CECS447-115902/CECS490A-Team1/hardware/pcb/README.md

# pcb/

KiCad project for the custom bracelet PCB.

- `bandlink_rev_a/`: first spin (flat test board)
- Pin assignment comes from `firmware/bandlink/bsp/bandlink_rev_a/cubemx/*.ioc`. Update both together.
- Export BOM CSVs to `hardware/bom/` and schematic PDFs to `hardware/schematic/` at each review.
