CECS447-115902/CECS490A-Team1/firmware/tools/README.md

# tools/

Scripts that help develop and test the firmware, for example:
- flashing helpers (STM32CubeProgrammer CLI)
- UART log capture from the pogo dock
- a LoRa packet decoder for sniffed captures (verifies R-06)
- PPK2 power-log analysis against the power budget
