CECS447-115902/CECS490A-Team1/reference/osptek-amoled-1.73-co5300/versions/AM173Q466466FLS/README.md

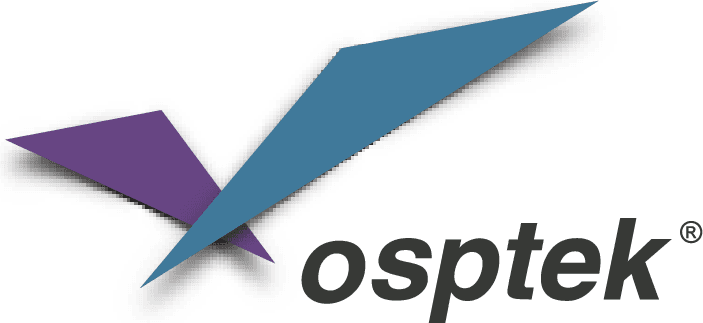
[picture p1: reference/osptek-amoled-1.73-co5300/versions/AM173Q466466FLS/images/logo.png]
OSPTEK


<h1 align="center">OSPTEK 1.73″ AMOLED 466×466（CO5300 · QSPI）</h1>

<p align="center"><b>圆形 AMOLED 模组 · QSPI · CO5300 · 电容触摸</b></p>

<p align="center"><a href="./README_EN.md">English</a> | 简体中文 · <a href="../../README.md">规格族索引</a></p>

<p align="center">
  
  
  
  
</p>

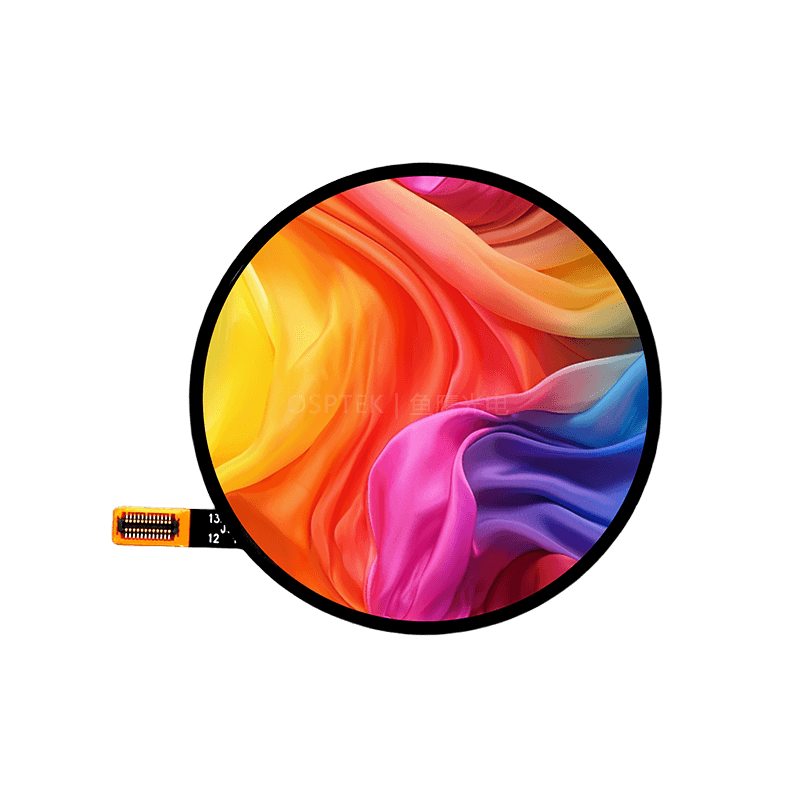
[picture p2: reference/osptek-amoled-1.73-co5300/versions/AM173Q466466FLS/images/product.png]
OSPTEK 1.73 寸 466×466 AMOLED QSPI 模组（CO5300）宣传图


## 目录

- [产品简介](#产品简介)
- [规格参数](#规格参数)
- [预编译固件](#预编译固件)
- [示例工程](#示例工程)
- [仓库结构](#仓库结构)
- [相关资料](#相关资料)
- [购买链接](#购买链接)
- [技术支持](#技术支持)

---

## 产品简介

OSPTEK **1.73 寸 466×466 AMOLED** 是一款 **QSPI** 接口圆形彩色显示模组，显示驱动为 **CO5300**，触摸驱动为 **CST820**。适合穿戴表盘、圆形仪表与小型圆形 HMI 等场景。

规格标识（仓库名）：`amoled-1.73-466x466-qspi-co5300`

当前模组版本：**AM173Q466466FLS**。电气与外形细节以 [`docs/AM_173_Q466466_FLS_c3c39f821c.pdf`](./docs/AM_173_Q466466_FLS_c3c39f821c.pdf) 为准。

## 规格参数

| 项目 | 规格 |
| ---- | ---- |
| 尺寸 | 1.73 英寸 |
| 类型 | AMOLED（彩色，圆形） |
| 分辨率 | 466×466 |
| 接口 | QSPI |
| 驱动 IC | CO5300 |
| 触摸驱动 | CST820 |

> 完整外形尺寸、FPC 定义、供电与时序以产品规格书 / 驱动手册为准。

## 预编译固件

不装 ESP-IDF 时可先烧录下面合并包，验证显示与触摸。

**建议适配组合：** 本模组（AM173Q466466FLS）+ **ESP32-S3 Demo 板**。其它主控 / 接线需自行改固件或源码。

| 底板（ESP32-S3 Demo） | 转接板 / 模组（AM173Q466466FLS） | 插接示意 |
| --- | --- | --- |
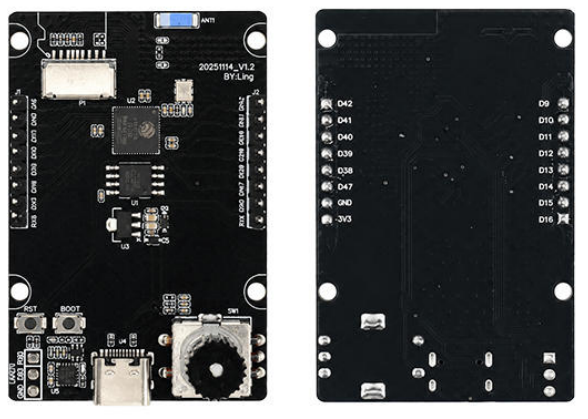
[picture p3: reference/osptek-amoled-1.73-co5300/versions/AM173Q466466FLS/images/esp32-s3-demo-board.png]
ESP32-S3 Demo 板
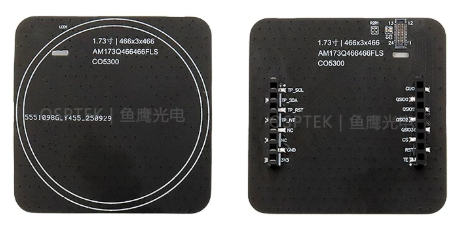
[picture p4: reference/osptek-amoled-1.73-co5300/versions/AM173Q466466FLS/images/module-front-back.png]
AM173Q466466FLS 模组
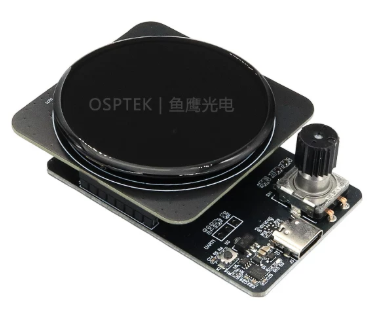
[picture p5: reference/osptek-amoled-1.73-co5300/versions/AM173Q466466FLS/images/assembled.png]
模组插接在 S3 Demo 板上
|  |  |  |

**引脚定义**

| 功能 | GPIO |
| ---- | ---- |
| LCD CS | 14 |
| LCD PCLK (CLK) | 9 |
| LCD DATA0 | 10 |
| LCD DATA1 | 11 |
| LCD DATA2 | 12 |
| LCD DATA3 | 13 |
| LCD RST | 15 |
| TOUCH SCL | 42 |
| TOUCH SDA | 41 |
| TOUCH RST | 40 |
| TOUCH INT | 39 |

| 文件 | 烧录地址 | 说明 |
| ---- | --- | ---- |
| [`firmware/esp32s3-amoled-1.73-466x466-qspi-co5300-bringup.bin`](./firmware/esp32s3-amoled-1.73-466x466-qspi-co5300-bringup.bin) | `0x0`（合并包） | 适配上方 S3 Demo 板 + 本模组的 bringup |

> 合并包请烧到 **`0x0`**，不要当成应用分区去烧 `0x10000`。

## 示例工程

| 说明 | 路径 |
| ---- | ---- |
| ESP32-S3 · CO5300 QSPI + esp-lvgl-adapter / LVGL8 | [`examples/esp32s3-idf5_co5300-qspi_esp-lvgl-adapter_lvgl8/`](./examples/esp32s3-idf5_co5300-qspi_esp-lvgl-adapter_lvgl8/) |
| ESP32-S3 · CO5300 QSPI + esp-lvgl-adapter / LVGL9 | [`examples/esp32s3-idf5_co5300-qspi_esp-lvgl-adapter_lvgl9/`](./examples/esp32s3-idf5_co5300-qspi_esp-lvgl-adapter_lvgl9/) |
| ESP32-S3 · LVGL8 + TE 防撕裂 | [`examples/with-te/esp32s3-idf5_co5300-qspi_esp-lvgl-adapter_lvgl8_amoled-with-te/`](./examples/with-te/esp32s3-idf5_co5300-qspi_esp-lvgl-adapter_lvgl8_amoled-with-te/) |
| ESP32-S3 · LVGL9 + TE 防撕裂 | [`examples/with-te/esp32s3-idf5_co5300-qspi_esp-lvgl-adapter_lvgl9_amoled-with-te/`](./examples/with-te/esp32s3-idf5_co5300-qspi_esp-lvgl-adapter_lvgl9_amoled-with-te/) |

## 仓库结构

```text
amoled-1.73-466x466-qspi-co5300/                                # 仓库根（导航见 ../../README.md）
└── versions/
    └── AM173Q466466FLS/                                # 本料号完整资料
        ├── README.md
        ├── README_EN.md
        ├── images/
        ├── docs/
        ├── firmware/
        └── examples/
```

## 相关资料

### 本产品资料

| 资料 | 链接 |
| ---- | ---- |
| 产品规格书（AM173Q466466FLS） | [`docs/AM_173_Q466466_FLS_c3c39f821c.pdf`](./docs/AM_173_Q466466_FLS_c3c39f821c.pdf) |
| 驱动 IC 数据手册（CO5300） | [`docs/CO_5300_Datasheet_V0_00_20230328_07edb82936.pdf`](./docs/CO_5300_Datasheet_V0_00_20230328_07edb82936.pdf) |
| 触摸 IC 数据手册（CST820） | [`docs/DS_CST_820_V1_2_e0543732ca.pdf`](./docs/DS_CST_820_V1_2_e0543732ca.pdf) |
| 初始化序列（文本） | [`docs/1.73_QSPI.txt`](./docs/1.73_QSPI.txt) |
| 1.73 寸 AMOLED 转接板原理图 | [`docs/1.73寸AMOLED转接板原理图.png`](./docs/1.73%E5%AF%B8AMOLED%E8%BD%AC%E6%8E%A5%E6%9D%BF%E5%8E%9F%E7%90%86%E5%9B%BE.png) |
| 1.73 寸 AMOLED QSPI 转接板 | [`docs/PCB-1.73寸AMOLED屏QSPI转接板.pdf`](./docs/PCB-1.73%E5%AF%B8AMOLED%E5%B1%8FQSPI%E8%BD%AC%E6%8E%A5%E6%9D%BF.pdf) |
| 连接器规格书（OK-23GF024-04） | [`docs/OK-23GF024-04.pdf`](./docs/OK-23GF024-04.pdf) |
| 预编译固件（ESP32-S3 合并包） | [`firmware/esp32s3-amoled-1.73-466x466-qspi-co5300-bringup.bin`](./firmware/esp32s3-amoled-1.73-466x466-qspi-co5300-bringup.bin) |

### 示例工程

- [ESP32-S3 CO5300 QSPI + LVGL8](./examples/esp32s3-idf5_co5300-qspi_esp-lvgl-adapter_lvgl8/)
- [ESP32-S3 CO5300 QSPI + LVGL9](./examples/esp32s3-idf5_co5300-qspi_esp-lvgl-adapter_lvgl9/)
- [ESP32-S3 LVGL8 + TE](./examples/with-te/esp32s3-idf5_co5300-qspi_esp-lvgl-adapter_lvgl8_amoled-with-te/)
- [ESP32-S3 LVGL9 + TE](./examples/with-te/esp32s3-idf5_co5300-qspi_esp-lvgl-adapter_lvgl9_amoled-with-te/)

## 购买链接

<p align="center">
  
  &nbsp;&nbsp;
  
</p>

**国内（淘宝）**

- 店铺：[鱼鹰光电工厂店](https://shop110742373.taobao.com/)

**海外（AliExpress）**

- 店铺：[OSPTEK Official Store](https://www.aliexpress.com/store/1105701619)

## 技术支持

- 技术支持 / 产品咨询：<luyu@osptek.com>
- QQ 技术交流群：**985881096**
- 公司官网：<https://osptek.com/>
- 有任何问题，都可以在本仓库 Issues 中提问

---

<p align="center"><sub>© 2026 OSPTEK 鱼鹰光电 · 本仓库资料采用 CC BY 4.0 许可</sub></p>
