CECS447-115902/CECS490A-Team1/reference/osptek-amoled-1.73-co5300/versions/AM173Q466466FLS/README_EN.md

<p align="left">OSPTEK</p>

<h1 align="center">OSPTEK 1.73″ AMOLED 466×466 (CO5300 · QSPI)</h1>

<p align="center"><b>Round AMOLED module · QSPI · CO5300 · capacitive touch</b></p>

<p align="center"><a href="./README.md">简体中文</a> | English · <a href="../../README_EN.md">Family index</a></p>

<p align="center">
  
  
  
  
</p>

<p align="center">OSPTEK 1.73 inch 466×466 AMOLED QSPI module (CO5300) product image</p>

## Contents

- [Overview](#overview)
- [Specifications](#specifications)
- [Prebuilt firmware](#prebuilt-firmware)
- [Sample projects](#sample-projects)
- [Repository layout](#repository-layout)
- [Resources](#resources)
- [Buy](#buy)
- [Support](#support)

---

## Overview

OSPTEK **1.73″ 466×466 AMOLED** is a round **QSPI** color display module driven by **CO5300**, with capacitive touch (**CST820**). Suited to wearables, round gauges, and compact circular HMI.

Spec ID (repository name): `amoled-1.73-466x466-qspi-co5300`

Current module version: **AM173Q466466FLS**. Electrical and mechanical details follow [`docs/AM_173_Q466466_FLS_c3c39f821c.pdf`](./docs/AM_173_Q466466_FLS_c3c39f821c.pdf).

## Specifications

| Item | Spec |
| ---- | ---- |
| Size | 1.73 inch |
| Type | AMOLED (color, round) |
| Resolution | 466×466 |
| Interface | QSPI |
| Driver IC | CO5300 |
| Touch driver | CST820 |

> Full outline, FPC definition, power, and timing follow the product datasheet / driver IC datasheet.

## Prebuilt firmware

Flash the merged image below to verify display and touch without building ESP-IDF.

**Intended hardware:** this module (AM173Q466466FLS) + the **ESP32-S3 Demo board**. Other MCUs / wiring need a different firmware or your own port.

| Base board (ESP32-S3 Demo) | Adapter / module (AM173Q466466FLS) | Assembled |
| --- | --- | --- |
| ESP32-S3 Demo board | AM173Q466466FLS module | Module plugged into S3 Demo board |

**Pin map**

| Function | GPIO |
| --- | ---- |
| LCD CS | 14 |
| LCD PCLK (CLK) | 9 |
| LCD DATA0 | 10 |
| LCD DATA1 | 11 |
| LCD DATA2 | 12 |
| LCD DATA3 | 13 |
| LCD RST | 15 |
| TOUCH SCL | 42 |
| TOUCH SDA | 41 |
| TOUCH RST | 40 |
| TOUCH INT | 39 |

| File | Address | Notes |
| ---- | --- | ----- |
| [`firmware/esp32s3-amoled-1.73-466x466-qspi-co5300-bringup.bin`](./firmware/esp32s3-amoled-1.73-466x466-qspi-co5300-bringup.bin) | `0x0` (merged) | Bringup for the S3 Demo board + this module |

> Flash the merged image at **`0x0`**, not `0x10000`.

## Sample projects

| Description | Path |
| ---- | ---- |
| ESP32-S3 · CO5300 QSPI + esp-lvgl-adapter / LVGL8 | [`examples/esp32s3-idf5_co5300-qspi_esp-lvgl-adapter_lvgl8/`](./examples/esp32s3-idf5_co5300-qspi_esp-lvgl-adapter_lvgl8/) |
| ESP32-S3 · CO5300 QSPI + esp-lvgl-adapter / LVGL9 | [`examples/esp32s3-idf5_co5300-qspi_esp-lvgl-adapter_lvgl9/`](./examples/esp32s3-idf5_co5300-qspi_esp-lvgl-adapter_lvgl9/) |
| ESP32-S3 · LVGL8 + TE | [`examples/with-te/esp32s3-idf5_co5300-qspi_esp-lvgl-adapter_lvgl8_amoled-with-te/`](./examples/with-te/esp32s3-idf5_co5300-qspi_esp-lvgl-adapter_lvgl8_amoled-with-te/) |
| ESP32-S3 · LVGL9 + TE | [`examples/with-te/esp32s3-idf5_co5300-qspi_esp-lvgl-adapter_lvgl9_amoled-with-te/`](./examples/with-te/esp32s3-idf5_co5300-qspi_esp-lvgl-adapter_lvgl9_amoled-with-te/) |

## Repository layout

```text
amoled-1.73-466x466-qspi-co5300/                                # repo root (nav: ../../README_EN.md)
└── versions/
    └── AM173Q466466FLS/                                # full materials for this part number
        ├── README.md
        ├── README_EN.md
        ├── images/
        ├── docs/
        ├── firmware/
        └── examples/
```

## Resources

### Product files

| Resource | Link |
| ---- | ---- |
| Product datasheet (AM173Q466466FLS) | [`docs/AM_173_Q466466_FLS_c3c39f821c.pdf`](./docs/AM_173_Q466466_FLS_c3c39f821c.pdf) |
| Driver IC datasheet (CO5300) | [`docs/CO_5300_Datasheet_V0_00_20230328_07edb82936.pdf`](./docs/CO_5300_Datasheet_V0_00_20230328_07edb82936.pdf) |
| Touch IC datasheet (CST820) | [`docs/DS_CST_820_V1_2_e0543732ca.pdf`](./docs/DS_CST_820_V1_2_e0543732ca.pdf) |
| Init sequence (text) | [`docs/1.73_QSPI.txt`](./docs/1.73_QSPI.txt) |
| 1.73″ AMOLED adapter schematic | [`docs/1.73寸AMOLED转接板原理图.png`](./docs/1.73%E5%AF%B8AMOLED%E8%BD%AC%E6%8E%A5%E6%9D%BF%E5%8E%9F%E7%90%86%E5%9B%BE.png) |
| 1.73″ AMOLED QSPI adapter board | [`docs/PCB-1.73寸AMOLED屏QSPI转接板.pdf`](./docs/PCB-1.73%E5%AF%B8AMOLED%E5%B1%8FQSPI%E8%BD%AC%E6%8E%A5%E6%9D%BF.pdf) |
| Connector datasheet (OK-23GF024-04) | [`docs/OK-23GF024-04.pdf`](./docs/OK-23GF024-04.pdf) |
| Prebuilt firmware (ESP32-S3 merged) | [`firmware/esp32s3-amoled-1.73-466x466-qspi-co5300-bringup.bin`](./firmware/esp32s3-amoled-1.73-466x466-qspi-co5300-bringup.bin) |

### Samples

- [ESP32-S3 CO5300 QSPI + LVGL8](./examples/esp32s3-idf5_co5300-qspi_esp-lvgl-adapter_lvgl8/)
- [ESP32-S3 CO5300 QSPI + LVGL9](./examples/esp32s3-idf5_co5300-qspi_esp-lvgl-adapter_lvgl9/)
- [ESP32-S3 LVGL8 + TE](./examples/with-te/esp32s3-idf5_co5300-qspi_esp-lvgl-adapter_lvgl8_amoled-with-te/)
- [ESP32-S3 LVGL9 + TE](./examples/with-te/esp32s3-idf5_co5300-qspi_esp-lvgl-adapter_lvgl9_amoled-with-te/)

## Buy

<p align="center">
  
  &nbsp;&nbsp;
  
</p>

**Overseas (AliExpress)**

- Store: [OSPTEK Official Store](https://www.aliexpress.com/store/1105701619)

**China (Taobao)**

- Store: [鱼鹰光电工厂店](https://shop110742373.taobao.com/)

## Support

- Technical support / product inquiry: <luyu@osptek.com>
- QQ group (China): **985881096**
- Website: <https://osptek.com/>
- Feel free to open an Issue in this repository if you have any questions

---

<p align="center"><sub>© 2026 OSPTEK · Materials in this repository are licensed under CC BY 4.0</sub></p>
