CECS447-115902/CECS490A-Team1/reference/osptek-amoled-1.73-co5300/versions/AM173Q466466FLS32/README_EN.md

<p align="left">OSPTEK</p>

<h1 align="center">OSPTEK 1.73″ AMOLED 466×466 (CO5300 · QSPI)</h1>

<p align="center"><b>Round AMOLED module · QSPI · CO5300 · capacitive touch</b></p>

<p align="center"><a href="./README.md">简体中文</a> | English · <a href="../../README_EN.md">Family index</a></p>

<p align="center">
  
  
  
  
</p>

## Contents

- [Overview](#overview)
- [Specifications](#specifications)
- [Repository layout](#repository-layout)
- [Resources](#resources)
- [Buy](#buy)
- [Support](#support)

---

## Overview

OSPTEK **1.73″ 466×466 AMOLED** is a round **QSPI** color display module driven by **CO5300**, with capacitive touch (**CST820**). Suited to wearables, round gauges, and compact circular HMI.

Spec ID (repository name): `amoled-1.73-466x466-qspi-co5300`

Current module version: **AM173Q466466FLS32**. Electrical and mechanical details follow [`docs/AM173Q466466FLS32.pdf`](./docs/AM173Q466466FLS32.pdf).

## Specifications

| Item | Spec |
| ---- | ---- |
| Size | 1.73 inch |
| Type | AMOLED (color, round) |
| Resolution | 466×466 |
| Interface | QSPI |
| Driver IC | CO5300 |
| Touch driver | CST820 |

> Full outline, FPC definition, power, and timing follow the product datasheet / driver IC datasheet.

## Repository layout

```text
amoled-1.73-466x466-qspi-co5300/                                # repo root (nav: ../../README_EN.md)
└── versions/
    └── AM173Q466466FLS32/                                      # full materials for this part number
        ├── README.md
        ├── README_EN.md
        ├── images/
        └── docs/
```

## Resources

### Product files

| Resource | Link |
| ---- | ---- |
| Product datasheet (AM173Q466466FLS32) | [`docs/AM173Q466466FLS32.pdf`](./docs/AM173Q466466FLS32.pdf) |
| Outline CAD (AM173Q466466FLS32) | [`docs/AM173Q466466FLS32.dwg`](./docs/AM173Q466466FLS32.dwg) |
| Driver IC datasheet (CO5300) | [`docs/CO_5300_Datasheet_V0_00_20230328_07edb82936.pdf`](./docs/CO_5300_Datasheet_V0_00_20230328_07edb82936.pdf) |
| Touch IC datasheet (CST820) | [`docs/DS_CST_820_V1_2_e0543732ca.pdf`](./docs/DS_CST_820_V1_2_e0543732ca.pdf) |

## Buy

<p align="center">
  
  &nbsp;&nbsp;
  
</p>

**International (AliExpress)**

- Store: [OSPTEK Official Store](https://www.aliexpress.com/store/1105701619)

**China (Taobao)**

- Store: [鱼鹰光电工厂店](https://shop110742373.taobao.com/)

## Support

- Technical Support / Sales: <luyu@osptek.com>
- QQ Technical Group: **985881096**
- Website: <https://osptek.com/>
- Feel free to open an Issue in this repository if you have any questions

---

<p align="center"><sub>© 2026 OSPTEK · Licensed under CC BY 4.0</sub></p>
