CECS447-115902/CECS490A-Team1/reference/osptek-amoled-1.73-co5300/README.md

<p align="left">OSPTEK</p>

<h1 align="center">OSPTEK 1.73″ AMOLED 466×466（CO5300 · QSPI）</h1>

<p align="center"><b>AMOLED 模组 · QSPI · CO5300 · 多版本索引</b></p>

<p align="center"><a href="./README_EN.md">English</a> | 简体中文</p>

<p align="center">
  
  
  
  
</p>

## 目录

- [说明](#说明)
- [版本一览](#版本一览)
- [AM173Q466466FLS32](#am173q466466fls32)
- [AM173Q466466FLS](#am173q466466fls)
- [购买链接](#购买链接)
- [技术支持](#技术支持)

---

## 说明

本仓库收录 **1.73 寸 466×466 AMOLED（QSPI · CO5300）** 显示模组资料。

**根目录 README 为导航页**。下表可快速浏览各版本；点击「完整资料」进入 `versions/` 下对应**料号文件夹**（产品页、规格书、示例均在该目录内）。

规格标识（仓库名）：`amoled-1.73-466x466-qspi-co5300`

---

## 版本一览

| 版本 | 宣传图 | 简介 | 完整资料 |
| ---- | --- | ---- | --- |
| AM173Q466466FLS32 |  | [简介](#am173q466466fls32) | [完整资料](./versions/AM173Q466466FLS32/) |
| AM173Q466466FLS | AM173Q466466FLS | [简介](#am173q466466fls) | [完整资料](./versions/AM173Q466466FLS/) |

---

## AM173Q466466FLS32

**说明：** 带触摸（CST820），FPC 24 Pin。

完整产品页、规格书与示例：[versions/AM173Q466466FLS32/](./versions/AM173Q466466FLS32/)

---

## AM173Q466466FLS

<p align="center">AM173Q466466FLS</p>

**说明：** 带触摸（CST820）。

完整产品页、规格书与示例：[versions/AM173Q466466FLS/](./versions/AM173Q466466FLS/)

---

## 购买链接

<p align="center">
  
  &nbsp;&nbsp;
  
</p>

**国内（淘宝）**

- 店铺：[鱼鹰光电工厂店](https://shop110742373.taobao.com/)

**海外（AliExpress）**

- 店铺：[OSPTEK Official Store](https://www.aliexpress.com/store/1105701619)

---

## 技术支持

- 技术支持 / 产品咨询：<luyu@osptek.com>
- QQ 技术交流群：**985881096**
- 公司官网：<https://osptek.com/>
- 有任何问题，都可以在本仓库 Issues 中提问

---

<p align="center"><sub>© 2026 OSPTEK 鱼鹰光电 · 本仓库资料采用 CC BY 4.0 许可</sub></p>
