CECS447-115902/CECS490A-Team1/reference/osptek-amoled-1.73-co5300/README_EN.md

<p align="left">OSPTEK</p>

<h1 align="center">OSPTEK 1.73″ AMOLED 466×466 (CO5300 · QSPI)</h1>

<p align="center"><b>AMOLED module · QSPI · CO5300 · Multi-Version Index</b></p>

<p align="center">English | <a href="./README.md">简体中文</a></p>

<p align="center">
  
  
  
  
</p>

## Contents

- [About](#about)
- [Versions](#versions)
- [AM173Q466466FLS32](#am173q466466fls32)
- [AM173Q466466FLS](#am173q466466fls)
- [Where to Buy](#where-to-buy)
- [Support](#support)

---

## About

This repository holds materials for the **1.73″ 466×466 AMOLED (QSPI · CO5300)** module family.

The **root README is the navigation page**. Use the table below for a quick scan; open **Full docs** to enter that **part-number folder** under `versions/` (product page, datasheets, and examples live there).

Repo id: `amoled-1.73-466x466-qspi-co5300`

---

## Versions

| Version | Image | Summary | Full docs |
| --- | ----- | --- | --- |
| AM173Q466466FLS32 |  | [Summary](#am173q466466fls32) | [Full docs](./versions/AM173Q466466FLS32/) |
| AM173Q466466FLS | AM173Q466466FLS | [Summary](#am173q466466fls) | [Full docs](./versions/AM173Q466466FLS/) |

---

## AM173Q466466FLS32

**Notes:** With touch (CST820), 24-pin FPC.

Full product page, datasheets, and examples: [versions/AM173Q466466FLS32/](./versions/AM173Q466466FLS32/)

---

## AM173Q466466FLS

<p align="center">AM173Q466466FLS</p>

**Notes:** With touch (CST820).

Full product page, datasheets, and examples: [versions/AM173Q466466FLS/](./versions/AM173Q466466FLS/)

---

## Where to Buy

<p align="center">
  
  &nbsp;&nbsp;
  
</p>

**International (AliExpress)**

- Store: [OSPTEK Official Store](https://www.aliexpress.com/store/1105701619)

**China (Taobao)**

- Store: [鱼鹰光电工厂店](https://shop110742373.taobao.com/)

---

## Support

- Technical Support / Sales: <luyu@osptek.com>
- QQ Technical Group: **985881096**
- Website: <https://osptek.com/>
- Feel free to open an Issue in this repository if you have any questions

---

<p align="center"><sub>© 2026 OSPTEK · Licensed under CC BY 4.0</sub></p>
