CECS447-115902/CECS490A-Team1/reference/osptek-amoled-1.73-co5300/versions/AM173Q466466FLS32/README.md

<p align="left">OSPTEK</p>

<h1 align="center">OSPTEK 1.73″ AMOLED 466×466（CO5300 · QSPI）</h1>

<p align="center"><b>圆形 AMOLED 模组 · QSPI · CO5300 · 电容触摸</b></p>

<p align="center"><a href="./README_EN.md">English</a> | 简体中文 · <a href="../../README.md">规格族索引</a></p>

<p align="center">
  
  
  
  
</p>

## 目录

- [产品简介](#产品简介)
- [规格参数](#规格参数)
- [仓库结构](#仓库结构)
- [相关资料](#相关资料)
- [购买链接](#购买链接)
- [技术支持](#技术支持)

---

## 产品简介

OSPTEK **1.73 寸 466×466 AMOLED** 是一款 **QSPI** 接口圆形彩色显示模组，显示驱动为 **CO5300**，触摸驱动为 **CST820**。适合穿戴表盘、圆形仪表与小型圆形 HMI 等场景。

规格标识（仓库名）：`amoled-1.73-466x466-qspi-co5300`

当前模组版本：**AM173Q466466FLS32**。电气与外形细节以 [`docs/AM173Q466466FLS32.pdf`](./docs/AM173Q466466FLS32.pdf) 为准。

## 规格参数

| 项目 | 规格 |
| ---- | ---- |
| 尺寸 | 1.73 英寸 |
| 类型 | AMOLED（彩色，圆形） |
| 分辨率 | 466×466 |
| 接口 | QSPI |
| 驱动 IC | CO5300 |
| 触摸驱动 | CST820 |

> 完整外形尺寸、FPC 定义、供电与时序以产品规格书 / 驱动手册为准。

## 仓库结构

```text
amoled-1.73-466x466-qspi-co5300/                                # 仓库根（导航见 ../../README.md）
└── versions/
    └── AM173Q466466FLS32/                                      # 本料号完整资料
        ├── README.md
        ├── README_EN.md
        ├── images/
        └── docs/
```

## 相关资料

### 本产品资料

| 资料 | 链接 |
| ---- | ---- |
| 产品规格书（AM173Q466466FLS32） | [`docs/AM173Q466466FLS32.pdf`](./docs/AM173Q466466FLS32.pdf) |
| 外形 CAD（AM173Q466466FLS32） | [`docs/AM173Q466466FLS32.dwg`](./docs/AM173Q466466FLS32.dwg) |
| 驱动 IC 数据手册（CO5300） | [`docs/CO_5300_Datasheet_V0_00_20230328_07edb82936.pdf`](./docs/CO_5300_Datasheet_V0_00_20230328_07edb82936.pdf) |
| 触摸 IC 数据手册（CST820） | [`docs/DS_CST_820_V1_2_e0543732ca.pdf`](./docs/DS_CST_820_V1_2_e0543732ca.pdf) |

## 购买链接

<p align="center">
  
  &nbsp;&nbsp;
  
</p>

**国内（淘宝）**

- 店铺：[鱼鹰光电工厂店](https://shop110742373.taobao.com/)

**海外（AliExpress）**

- 店铺：[OSPTEK Official Store](https://www.aliexpress.com/store/1105701619)

## 技术支持

- 技术支持 / 产品咨询：<luyu@osptek.com>
- QQ 技术交流群：**985881096**
- 公司官网：<https://osptek.com/>
- 有任何问题，都可以在本仓库 Issues 中提问

---

<p align="center"><sub>© 2026 OSPTEK 鱼鹰光电 · 本仓库资料采用 CC BY 4.0 许可</sub></p>
