CECS447-115902/CECS490A-Team1/docs/ui/Justin’s Watch UI Rought Sketch.pdf

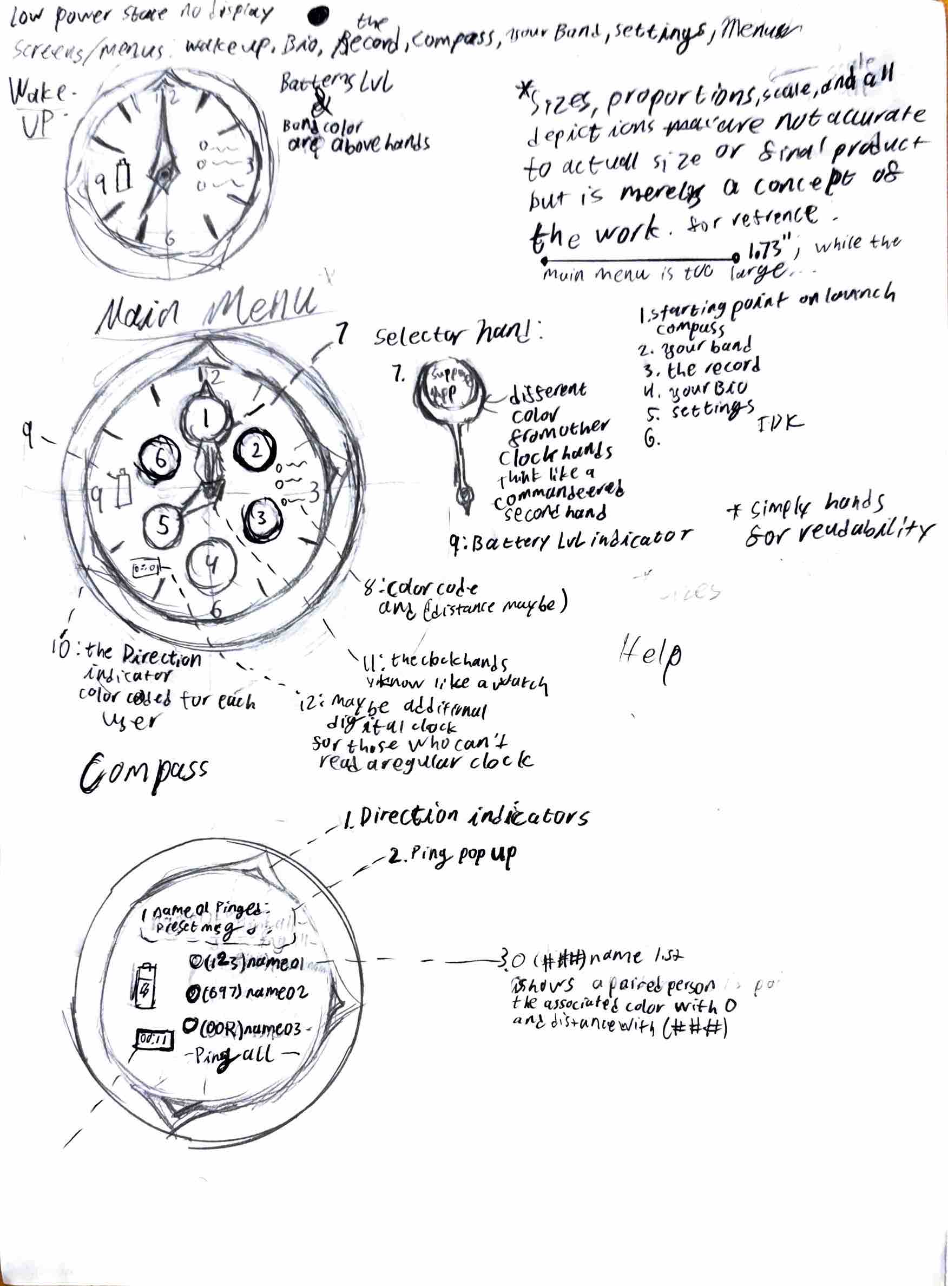
[picture p16: page 1]

f ~; Mf {Cf h(I ~ d J
8-of ,-e<Adalo,tl/fy

t L;;,

L

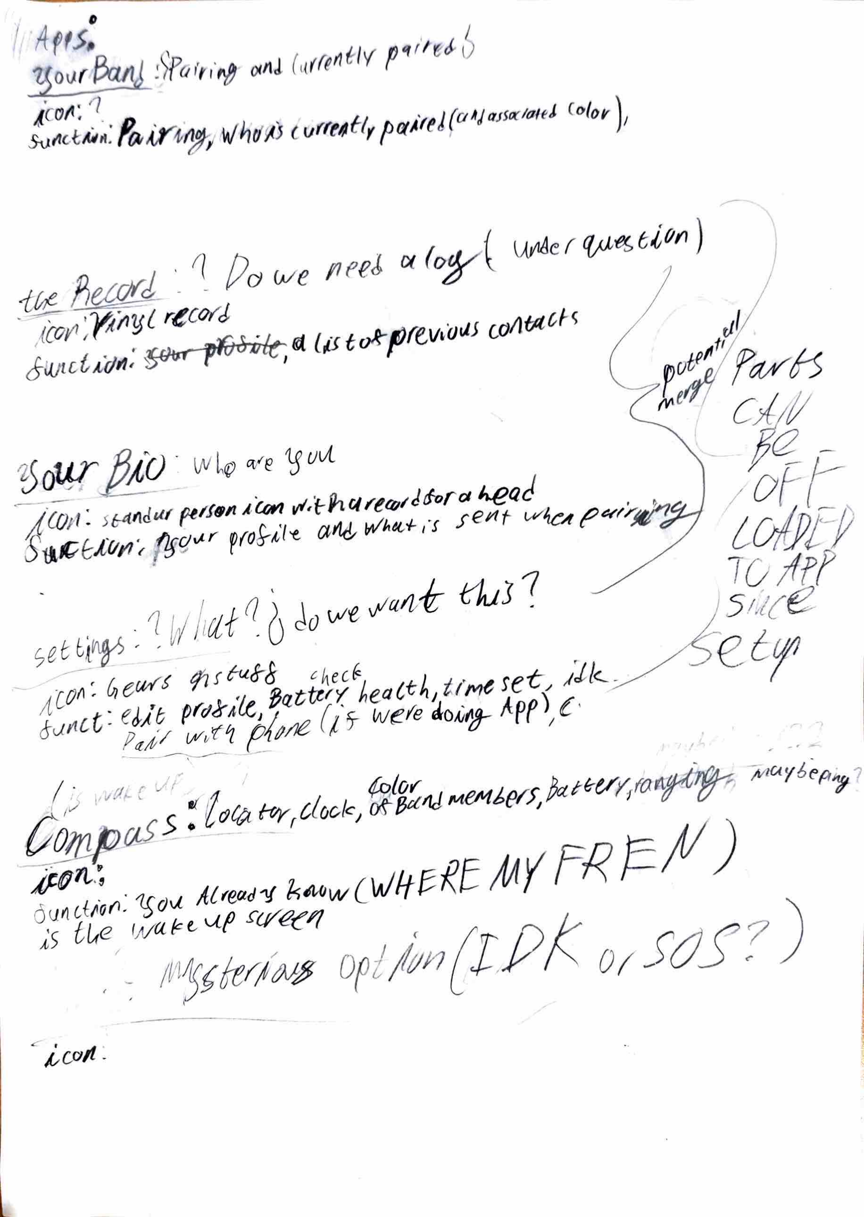
[picture p17: page 2]

L

# l At,.s:

?;$0tJr/3a,,J !>fo,,,·'}J OlnJ (1<ffft1f:I'( pqrt~J.l)

4cr,11; '7_

S,Jtte,t,,.;,/ fa, if"1,1Jf;, W '111 eJ) l vrre1tt, f)(.r ire I( a A/ a»~ 1t11eJ Co(();-),

1:5oW j},itJ • w~ <Ve 1f ut,{
.,--- - d {{J;,1: 5t;-41'1c1',IF pt,f11,z A'cwi 11",'f:-h ""'e01'dtforct ¥!Qd
3
1

a~f,,{f/1'1~ /f!JCJ"'r prot~'{-e, arl& Wh.«,,-i- ,·s fe"1t Wb pe:,,I'~

I
I

I
I
