CECS447-115902/CECS490A-Team1/reference/osptek-amoled-1.73-co5300/versions/AM173Q466466FLS/docs/1.73#U5bf8AMOLED#U8f6c#U63a5#U677f#U539f#U7406#U56fe.png

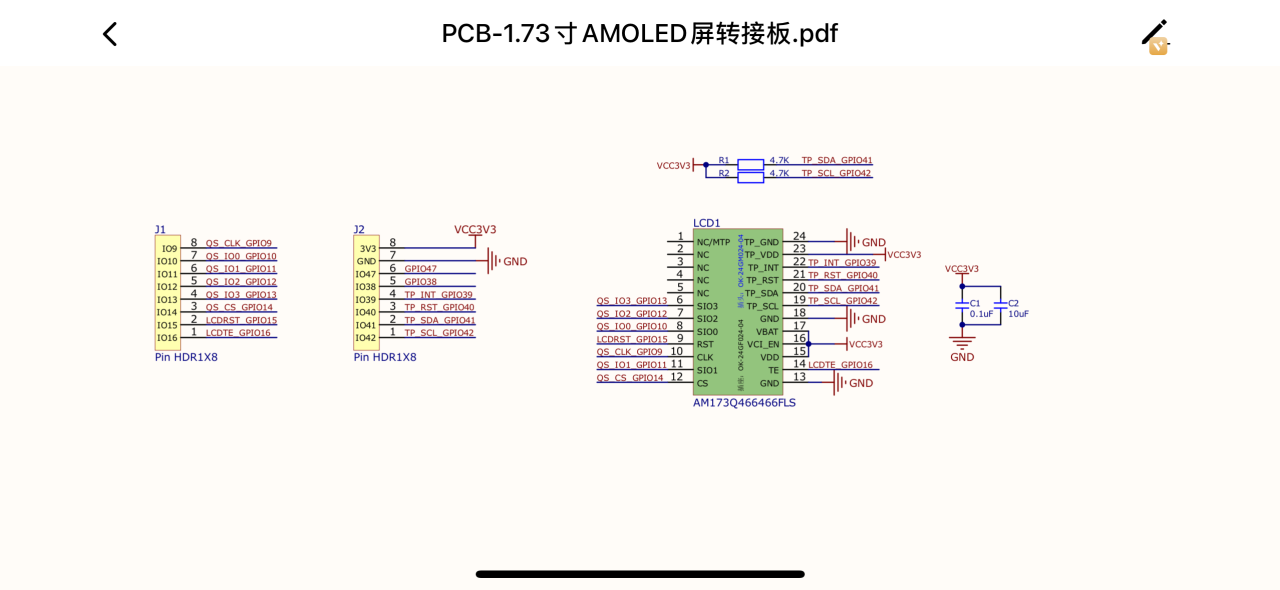
reference/osptek-amoled-1.73-co5300/versions/AM173Q466466FLS/docs/1.73#U5bf8AMOLED#U8f6c#U63a5#U677f#U539f#U7406#U56fe.png
