CECS447-115902/CECS490A-Team1/docs/budget/BandLink_BOM_Power_Budget.xlsx

Sheet: Summary
BandLink — BOM & power summary
CECS 490A Team 1 · scope: MVP + Stretch 1 + Stretch 2 · all values recalc from BOM / Power / Inputs tabs
Section | MVP $ | S1 $ | S2 $ | Per unit/set $ | Multiplier | Section total $
Dev bring-up (per set) | $187.5 | $48 | $35 | $270.5 | 2 | $541
Custom PCB (per bracelet) | $107.75 | $35.5 | $23 | $166.25 | 3 | $498.75
Team tools (one-time) | $111 | $130 | $0 | $241 | 1 | $241
Project total |  |  |  |  |  | $1280.75
MVP-only spend (dev sets + MVP tools) |  |  |  |  |  | $486
Line items priced as estimates |  |  |  |  |  | 34 of 40
Power (final build) | Standby | Typical | Finding | Blended day |  | R-03 target
Battery current (mA) | 16.6 | 24.4 | 60.0 | 26.0
Runtime (h) | 25.6 | 17.5 | 7.1 | 16.4 |  | 8
Managed peak at battery (mA) / C-rate | 452.9929412 | 0.91C
LoRa time on air per packet (s) / FCC dwell | 0.206 | OK
Design decisions baked into this BOM
1. BQ25120A dropped as the system regulator: its 300 mA buck is below the ~350 mA managed rail peak (530 mA worst case). TPS63802 buck-boost for 3.3 V, BQ25180 for charging.
2. SX1262 VBAT abs-max is below a full LiPo (4.2 V): radio sits on the 3.3 V rail, never on raw battery.
3. Biggest power levers, in order: GNSS duty (power-save / cyclic tracking), LoRa RX scheduling (GPS-synced TDMA, Inputs!B28), AMOLED on-time.
4. Firmware interlock: never run the NFC field during LoRa TX or UWB ranging - keeps the peak inside the cell's pulse rating.
5. UWB (S2) is distance-only; direction still comes from GPS bearing + BNO085 rotation-vector heading.
6. Multi-hop relay (S2) is firmware-only - no BOM cost, modeled as the relay TX multiplier on the Power tab.
7. Red 'Estimate' prices on the BOM tab need a distributor check before the order goes in.

Sheet: Inputs
Inputs & assumptions
Blue = editable input. Yellow = key assumption worth measuring. Black = formula.
Bracelets to build (custom PCB, 490B) | 3 | 2 for demo + 1 spare
Dev-board sets (490A bring-up) | 2 | One set per bracelet for the 500 m MVP test
Battery capacity (mAh) | 500 | Adafruit 1578, 500 mAh w/ PCM, 29x36x4.75 mm (was 370 mAh Jauch LP402535)
Usable capacity fraction | 85% | Cutoff at 3.0 V, aging, cold; small LiPo cells rarely deliver rated mAh at load
Battery nominal voltage (V) | 3.7
Main rail voltage (V) | 3.3 | All loads modeled at 3.3 V rail; 1.8 V loads sit behind an LDO from 3.3 V
Buck-boost efficiency (typical load) | 90% | TPS63802-class at 10-100 mA
R-03 runtime target (h) | 8 | From proposal R-03
Battery min voltage (V) | 3 | Worst case for peak-current check
Buck-boost efficiency at peak load | 85%
Battery max pulse discharge (C) | 2 | Check the actual cell datasheet; many small cells are 1C cont / 2C pulse
LoRa airtime (Semtech SX126x time-on-air formula)
Spreading factor (SF) | 9 | SF9 is a reasonable start for 0.5-1 km wrist-to-wrist
Bandwidth (Hz) | 125000
Coding rate index (1 = 4/5) | 1
Preamble symbols | 8
Payload bytes | 24 | id 2 + seq 2 + lat/lon 8 + alt 2 + time 4 + flags 2 + AES-CCM MIC 4
CRC on (1/0) | 1
Implicit header (1/0) | 0
Low data rate optimize (auto) | 0 | Required for symbol time > 16 ms
Symbol time (s) | 0.004096
Time on air per packet (s) | 0.206
FCC 15.247 dwell limit per channel (s) | 0.4 | Max 0.4 s per hop channel in a 20 s window (915 MHz FHSS)
Dwell check | OK
GPS-synced TDMA RX (1 = on, 0 = continuous RX) | 0 | Biggest single power lever: wake RX only in peers' PPS-aligned slots
Paired peers in group | 3
RX guard per slot (s) | 0.05 | PPS jitter + SX1262 wake/calibration

Sheet: BOM
Bill of materials — scope locked through Stretch 2
Prices are USD at qty 1-10. 'Sourced' = distributor listing found Oct 2026; 'Estimate' = verify before ordering. Tier: MVP / S1 / S2.
# | Section | Subsystem | Part | MPN / SKU | Tier | Interface / bus | Qty | Unit $ | Ext $ | Price basis | Notes
1 | Dev bring-up (per set) | MCU | NUCLEO-U5A5ZJ-Q | NUCLEO-U5A5ZJ-Q | MVP | SWD / USB | 1 | $30.00 | $30.00 | Estimate | Same U5 family + 2.5 MB SRAM, no GPU. MVP firmware runs here; port to U5A9 is pin/HAL-level.
2 | Dev bring-up (per set) | GNSS | SparkFun GNSS Breakout MAX-M10S (Qwiic) | GPS-18037 | MVP | UART (or I2C 0x42) + PPS | 1 | $45.00 | $45.00 | Estimate | Wire PPS to an EXTI/timer-capture pin now; TDMA depends on it.
3 | Dev bring-up (per set) | LoRa | SX1262 915 MHz breakout + SMA whip | e.g. Waveshare Core1262-HF | MVP | SPI + BUSY + DIO1 + NRESET | 1 | $20.00 | $20.00 | Estimate | Must poll BUSY before every SPI command.
4 | Dev bring-up (per set) | NFC | MIKROE NFC 2 Click | PN7150 | MVP | I2C + IRQ + VEN | 1 | $35.00 | $35.00 | Sourced | SparkFun listed $34.95 (retired there); buy from MIKROE.
5 | Dev bring-up (per set) | IMU (9-DOF fusion) | Adafruit BNO085 9-DOF Orientation IMU Fusion Breakout (STEMMA QT) | Adafruit 4754 | MVP | I2C 0x4A + INT + RST (SPI via PS0/PS1 jumpers) | 1 | $29.50 | $29.50 | Sourced | Team choice. Accel + gyro + mag + on-chip fusion: firmware reads a rotation-vector quaternion, so no host-side compass fusion or tilt compensation. Host I2C must support clock stretching.
6 | Dev bring-up (per set) | Display | 1.28" round TFT 240x240 | GC9A01 module | MVP | SPI | 1 | $10.00 | $10.00 | Estimate | Cheap MVP screen; LVGL port carries over to AMOLED.
7 | Dev bring-up (per set) | Haptic | Coin ERM motor + MOSFET | generic 10 mm ERM | MVP | GPIO / PWM | 1 | $3.00 | $3.00 | Estimate
8 | Dev bring-up (per set) | Power | USB power bank (field test) | generic | MVP | USB | 1 | $15.00 | $15.00 | Estimate | Powers dev boards for the 500 m walk test.
9 | Dev bring-up (per set) | Display | 1.43" AMOLED 466x466 module w/ touch | Waveshare 1.43" AMOLED (CO5300) | S1 | QSPI (OCTOSPI) + I2C touch + TE | 1 | $25.00 | $25.00 | Estimate | Confirm driver IC (CO5300 vs SH8601) on the exact listing.
10 | Dev bring-up (per set) | Haptic | DRV2605L breakout + 8 mm LRA | Adafruit 2305 + G0832022D-class LRA | S1 | I2C + EN | 1 | $13.00 | $13.00 | Estimate | Run DRV2605L auto-calibration per LRA.
11 | Dev bring-up (per set) | Crown | Bourns PEC06 encoder w/ switch | PEC06 | S1 | 2x GPIO (TIM encoder mode) + 1 GPIO | 1 | $4.00 | $4.00 | Estimate | 6 pulses/rev; RC filter per Bourns app circuit.
12 | Dev bring-up (per set) | Power | MAX17048 fuel gauge breakout | Adafruit 5580 | S1 | I2C + ALRT | 1 | $6.00 | $6.00 | Estimate
13 | Dev bring-up (per set) | UWB | Qorvo DWM3000EVB (Arduino shield) | DWM3000EVB | S2 | SPI + IRQ + WAKEUP + RSTn | 1 | $35.00 | $35.00 | Estimate | Distance only (single antenna) - no direction arrow.
14 | Custom PCB (per bracelet) | MCU | STM32U5A9 4 MB flash, 2.5 MB SRAM, NeoChrom | STM32U5A9VJT6Q (LQFP100) | MVP | - | 1 | $16.00 | $16.00 | Estimate | ST eStore $9.96 @10k. LQFP avoids BGA. Verify OCTOSPI pin availability for QSPI panel in LQFP100.
15 | Custom PCB (per bracelet) | MCU | 32.768 kHz + HSE crystals | - | MVP | - | 1 | $1.50 | $1.50 | Estimate | LSE needed for RTC/LPTIM in Stop 2.
16 | Custom PCB (per bracelet) | GNSS | u-blox MAX-M10S | MAX-M10S-00B | MVP | UART + PPS + RESET_N | 1 | $17.00 | $17.00 | Estimate | Integrated LNA + SAW: passive antenna OK.
17 | Custom PCB (per bracelet) | GNSS | L1 chip antenna | - | MVP | RF | 1 | $2.00 | $2.00 | Estimate | Needs ground plane + keepout; wrist detunes it.
18 | Custom PCB (per bracelet) | LoRa | SX1262 module, 22 dBm, TCXO | e.g. Ebyte E22-900M22S | MVP | SPI + BUSY + DIO1 + NRESET + RXEN/TXEN | 1 | $8.00 | $8.00 | Estimate | Module avoids chip-down RF layout. SX1262 VBAT max 3.7 V - feed from 3.3 V rail, never raw battery.
19 | Custom PCB (per bracelet) | LoRa | 915 MHz antenna (FPC/chip) | - | MVP | RF | 1 | $3.00 | $3.00 | Estimate
20 | Custom PCB (per bracelet) | NFC | NXP PN7150 NFC controller | PN7150B0HN/C11002 | MVP | I2C + IRQ + VEN | 1 | $10.00 | $10.00 | Sourced | Farnell EUR 8.98 @5. PN7160 drops P2P - if you switch, pair via card emulation instead.
21 | Custom PCB (per bracelet) | NFC | NFC antenna coil + matching network | PCB trace or FPC | MVP | RF | 1 | $2.00 | $2.00 | Estimate | Metal/battery under coil kills coupling - use ferrite sheet.
22 | Custom PCB (per bracelet) | IMU (9-DOF fusion) | CEVA BNO085 + 32.768 kHz crystal | BNO085 | MVP | SPI (PS0/PS1 = 1/1) + H_INTN + NRST + PS0/WAKE | 1 | $18.00 | $18.00 | Estimate | VDD 2.4-3.6 V on the 3.3 V rail. Use SPI on the custom PCB to avoid BNO08x I2C quirks. BOOTN to a test pad for firmware updates. Keep away from the LRA magnet and battery.
23 | Custom PCB (per bracelet) | Power | 3.3 V buck-boost | TPS63802 | MVP | - | 1 | $2.00 | $2.00 | Estimate | Replaces BQ25120A buck (300 mA max is below the ~350 mA managed rail peak).
24 | Custom PCB (per bracelet) | Power | 1.8 V LDO | TLV75518P | MVP | - | 1 | $0.30 | $0.30 | Estimate | PN7150 pad supply (VDD(PAD) 1.65-1.95 V).
25 | Custom PCB (per bracelet) | Battery | LiPo 500 mAh w/ PCM, 29x36x4.75 mm | Adafruit 1578 | MVP | - | 1 | $7.95 | $7.95 | Sourced | Adafruit $7.95 qty1-9, 10.5 g, PCM cuts off at 3.0 V. Charge at <=1C (no thermistor in pack). Max discharge not published - confirm.
26 | Custom PCB (per bracelet) | PCB | 4-layer PCB, ~40 mm round | JLC-class | MVP | - | 1 | $6.00 | $6.00 | Estimate | Per-board share of a 5-pc order.
27 | Custom PCB (per bracelet) | Misc | Passives, ESD/TVS, connectors | - | MVP | - | 1 | $8.00 | $8.00 | Estimate
28 | Custom PCB (per bracelet) | Mech | Enclosure + strap | 3D printed | MVP | - | 1 | $6.00 | $6.00 | Estimate
29 | Custom PCB (per bracelet) | Display | 1.43" AMOLED 466x466 panel w/ CTP | CO5300 / SH8601 QSPI panel | S1 | QSPI + TE + RESET + I2C touch | 1 | $20.00 | $20.00 | Estimate | Check whether FPC needs external ELVDD/ELVSS supply - adds a PMIC if so.
30 | Custom PCB (per bracelet) | Haptic | Haptic driver | DRV2605LDGST | S1 | I2C + EN | 1 | $2.50 | $2.50 | Estimate
31 | Custom PCB (per bracelet) | Haptic | 8 mm coin LRA, 235 Hz | 0832-class | S1 | - | 1 | $2.00 | $2.00 | Estimate
32 | Custom PCB (per bracelet) | Crown | Bourns PEC06 encoder | PEC06 | S1 | GPIO | 1 | $2.50 | $2.50 | Estimate
33 | Custom PCB (per bracelet) | Power | Linear charger w/ power path | BQ25180 | S1 | I2C + INT | 1 | $1.50 | $1.50 | Estimate | Power path keeps system alive while charging on the dock.
34 | Custom PCB (per bracelet) | Power | Fuel gauge | MAX17048G+T10 | S1 | I2C + ALRT | 1 | $3.00 | $3.00 | Estimate | 3 uA hibernate / 23 uA active.
35 | Custom PCB (per bracelet) | Power | Magnetic pogo connector, 4-pin | generic | S1 | VBUS, GND, UART TX/RX | 1 | $4.00 | $4.00 | Estimate | UART on pogo = bootloader + debug console on the dock.
36 | Custom PCB (per bracelet) | UWB | Qorvo DWM3000 module | DWM3000TR13 | S2 | SPI + IRQ + WAKEUP + RSTn | 1 | $23.00 | $23.00 | Sourced | DigiKey EUR 20.33. Use channel 5 (lower current than ch 9).
37 | Team tools (one-time) | UI dev | STM32U5G9J-DK1 Discovery | STM32U5G9J-DK1 | S1 | - | 1 | $90.00 | $90.00 | Sourced | Farnell EUR 86.14. NeoChrom + round display for LVGL bring-up. The U5A9J-DK is NRND.
38 | Team tools (one-time) | Debug | STLINK-V3MINIE | STLINK-V3MINIE | MVP | SWD | 1 | $12.00 | $12.00 | Estimate
39 | Team tools (one-time) | Debug | Tag-Connect cable | TC2030-CTX-NL | S1 | SWD | 1 | $40.00 | $40.00 | Estimate | Lets the custom PCB skip a debug header.
40 | Team tools (one-time) | Test | Power profiler | Nordic PPK2 | MVP | USB | 1 | $99.00 | $99.00 | Estimate | Measures the duty-cycle numbers on the Power tab instead of guessing them.

Sheet: Power
Power budget — final build (MVP + S1 + S2 hardware)
Currents at the 3.3 V rail. Avg = active x duty + sleep x (1 - duty). Edit blue duty cycles after measuring with the PPK2.
Scenario parameters |  |  |  | Standby tracking | Typical event | Active finding
Own position TX interval (s) |  |  |  | 10 | 5 | 2
Relay TX multiplier (S2 multi-hop) |  |  |  | 1 | 1.5 | 1.5
Share of an 8 h event day |  |  |  | 25% | 65% | 10% | 100% | <- must be 100%
LoRa TX duty |  |  |  | 2.1% | 6.2% | 15.4%
LoRa RX duty |  |  |  | 97.9% | 93.8% | 84.6%
Component | Active state | Active mA | Sleep mA | Duty: Standby | Duty: Typical | Duty: Finding | Avg mA: Standby | Avg mA: Typical | Avg mA: Finding | Peak mA | Tier | Basis
MCU STM32U5A9 | Run 160 MHz + DMA/GPU; sleep = Stop 2, full SRAM | 8 | 0.0175 | 3.0% | 10.0% | 40.0% | 0.257 | 0.816 | 3.211 | 15 | MVP | ST: 18.5 uA/MHz run (=3 mA core @160 MHz), 17.5 uA Stop 2 w/ 2.5 MB SRAM. 8 mA active adds GPU/OCTOSPI/DMA - estimate.
GNSS MAX-M10S | Continuous tracking; sleep = backup | 8 | 0.035 | 100.0% | 100.0% | 100.0% | 8.000 | 8.000 | 8.000 | 25 | MVP | u-blox: <25 mW continuous tracking (~7.6 mA @3.3 V). Peak = acquisition. Backup current estimate.
LoRa SX1262 TX | +22 dBm | 118 | 0 | 2.1% | 6.2% | 15.4% | 2.429 | 7.286 | 18.215 | 118 | MVP | Semtech: 118 mA @ +22 dBm. Duty from Inputs time-on-air / interval x relay.
LoRa SX1262 RX | LoRa RX 125 kHz; sleep = warm-start sleep | 4.6 | 0.0006 | 97.9% | 93.8% | 84.6% | 4.505 | 4.316 | 3.890 | 5 | MVP | Semtech: 4.6 mA RX (DC-DC). Sleep ~0.6 uA.
UWB DWM3000 | DS-TWR @10 Hz, RX-dominated; sleep = deep sleep | 50 | 0.0009 | 0.0% | 0.0% | 3.0% | 0.001 | 0.001 | 1.501 | 55 | S2 | DigiKey: RX 50-55 mA, TX 40-45 mA; sleep 0.26-0.85 uA. 3% = ~3 ms radio-on per 100 ms exchange - estimate.
NFC PN7150 | RF field polling (pairing only); sleep = standby/HPD | 60 | 0.01 | 0.05% | 0.05% | 0.05% | 0.040 | 0.040 | 0.040 | 180 | MVP | NXP: 180 mA max RF driver current. Active avg + standby are estimates; keep in HPD via VEN except during pairing.
IMU BNO085 (9-DOF fusion) | Rotation vector (accel+gyro+mag fusion); sleep = accel-only significant-motion/tap wake | 5.3 | 0.1 | 5.0% | 15.0% | 100.0% | 0.360 | 0.880 | 5.300 | 10 | MVP | CEVA BNO08X DS v1.16 sensor-metadata example: rotation vector 5.30 mA operating. Sleep 0.1 mA and 10 mA peak are estimates - DS power figures (sec 6.10) not extracted; measure with PPK2.
AMOLED 1.43" 466x466 | Dark UI (~30-40% APL); sleep = sleep-in | 20 | 0.05 | 5.0% | 15.0% | 100.0% | 1.048 | 3.042 | 20.000 | 42 | S1 | Panel spec: ELVDD/ELVSS 33 mA + VCI 6 + VDDIO 3 mA typ (full pattern) = 42 peak. 20 mA dark-UI figure is an estimate - measure.
Haptic DRV2605L + LRA | LRA drive; sleep = EN low | 65 | 0.004 | 0.1% | 0.2% | 0.5% | 0.069 | 0.134 | 0.329 | 80 | S1 | LRA 0832: 58-80 mA rated. Driver standby estimate.
Fuel gauge MAX17048 | Active; sleep = hibernate | 0.023 | 0.003 | 100.0% | 100.0% | 100.0% | 0.023 | 0.023 | 0.023 | 0.04 | S1 | ADI: 23 uA active, 3 uA hibernate (sits on battery; small modeling error).
Regulator / charger Iq | TPS63802 + LDO + BQ25180 | 0.015 | 0 | 100.0% | 100.0% | 100.0% | 0.015 | 0.015 | 0.015 | 0 | MVP | Estimate - check TPS63802 Iq in the mode you configure.
Encoder pull-ups + leakage | - | 0.02 | 0 | 100.0% | 100.0% | 100.0% | 0.020 | 0.020 | 0.020 | 0 | S1 | Estimate.
Total rail current (mA @3.3 V) |  |  |  |  |  |  | 16.8 | 24.6 | 60.5
Battery current (mA) |  |  |  |  |  |  | 16.6 | 24.4 | 60.0
Runtime (h) |  |  |  |  |  |  | 25.6 | 17.5 | 7.1
Meets R-03? |  |  |  |  |  |  | YES | YES | NO
Blended 8 h event day — avg battery current (mA) |  |  |  |  |  |  | 26.0
Blended runtime (h) |  |  |  |  |  |  | 16.4
Blended margin vs R-03 (h) |  |  |  |  |  |  | +8.4
Peak current check
Worst-case simultaneous peak, rail (mA) |  |  |  |  |  |  |  |  |  | 530.04
Managed peak: firmware interlock, no NFC field during LoRa TX / UWB (mA) |  |  |  |  |  |  |  |  |  | 350.04
Managed peak at battery, Vbat min (mA) |  |  |  |  |  |  |  |  |  | 452.9929412
Managed peak C-rate |  |  |  |  |  |  |  |  |  | 0.91C
Within cell pulse rating? |  |  |  |  |  |  |  |  |  | YES
BQ25120A 300 mA buck sufficient? |  |  |  |  |  |  |  |  |  | NO - use TPS63802-class buck-boost

Sheet: Sources
Sources (checked Oct 2026)
Item | URL
STM32U599/U5A9 power figures | https://www.st.com/en/microcontrollers-microprocessors/stm32u599nj.html
STM32U5A9VJT6Q price ($9.96 @10k) | https://estore.st.com/en/products/microcontrollers-microprocessors/stm32-32-bit-arm-cortex-mcus/stm32-ultra-low-power-mcus/stm32u5-series/stm32u599-5a9/stm32u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
STM32U5G9J-DK1 (active) / U5A9J-DK (NRND) | https://st.com/en/evaluation-tools/stm32u5g9j-dk1.html
STM32U5G9J-DK1 price | https://fr.farnell.com/stmicroelectronics/stm32u5g9j-dk1/kit-discovery-32bit-arm-cortex/dp/4308671
MAX-M10S datasheet | https://content.u-blox.com/sites/default/files/MAX-M10S_DataSheet_UBX-20035208.pdf
SparkFun MAX-M10S breakout | https://sparkfun.com/products/18037
SX1262 product page | https://www.semtech.com/products/wireless-rf/lora-connect/sx1262
SX1262 TX/RX currents | https://everythingrf.com/products/rf-transceivers/semtech/531-690-sx1262
DWM3000TR13 (DigiKey) | https://www.digikey.fr/en/products/detail/qorvo/DWM3000TR13/24367320
DWM3000 sleep current | https://www.everythingrf.com/products/rf-modules/qorvo/528-483-dwm3000
PN7150 price | https://fr.farnell.com/nxp/pn7150b0hn-c11002y/rfid-lect-ecrit-13-56mhz-hvqfn/dp/2663167
NFC 2 Click (PN7150) | https://www.sparkfun.com/products/18779
Adafruit BNO085 breakout (4754), $29.50 | https://www.adafruit.com/products/4754
Adafruit BNO085 guide (I2C quirks) | https://learn.adafruit.com/adafruit-9-dof-orientation-imu-fusion-breakout-bno085/overview
CEVA BNO08X datasheet | https://www.ceva-ip.com/wp-content/uploads/BNO080_085-Datasheet.pdf
1.43" AMOLED panel power spec | https://atta.szlcsc.com/upload/public/pdf/source/20250918/0EE5B149EEEC300C09910D138CD902A9.pdf
Waveshare 1.43" AMOLED (CO5300/SH8601) | https://www.waveshare.com/product/esp32-s3-touch-amoled-1.43.htm
BQ25120A (300 mA buck limit) | https://ti.com/product/BQ25120A
MAX17048 | https://www.analog.com/en/products/max17048.html
Bourns PEC06 | https://bourns.com/docs/Product-Datasheets/PEC06.pdf
LRA 0832 / DRV2605 (Vibro Motor 3 Click) | https://www.sparkfun.com/mikroe-vibro-motor-3-click.html
Adafruit 1578 LiPo 500 mAh | https://www.adafruit.com/product/1578
