CECS447-115902/CECS490A-Team1/(list of files, cad)

Other CAD files:
reference/osptek-amoled-1.73-co5300/versions/AM173Q466466FLS32/docs/AM173Q466466FLS32.dwg
