CECS447-115902/CECS490A-Team1/(commit log)

2026-10-29 Revise BandLink proposal sections to clarify MVP components and update prototype order details
2026-11-05 Docs-only cleanup: switch design docs to FreeRTOS, remove placeholder code, add architecture PDFs
